HSBNE/VendingMachine_MotorDriver/PCB/Main v1.2/Project Outputs for HSBNE-MAIN/Gerber/HSBNE-MOTOR.TXT

M48
;Layer_Color=9474304
;FILE_FORMAT=4:4
METRIC,LZ
;TYPE=PLATED
T1F00S00C0.3000
T2F00S00C0.8000
T3F00S00C1.0000
T4F00S00C1.0160
T5F00S00C1.1000
T6F00S00C1.5000
T7F00S00C1.6000
T8F00S00C4.5000
;TYPE=NON_PLATED
T9F00S00C0.9000
T10F00S00C2.0000
T11F00S00C3.0000
T12F00S00C3.2500
T13F00S00C4.5000
%
T01
X000381Y-0089027
X000762Y-0088011
X0015113Y-0089662
X001524Y-009398
X0017907Y-0094742
X0018034Y-0096901
X0019177Y-0098171
X0020955Y-0092964
X0018034Y-0092202
X0027559Y-0093472
Y-0096012
X0029464Y-009525
X0031877Y-009652
X0034036Y-0096393
X0034163Y-0092075
X0037084Y-009271
X004064
Y-0095885
X0039116Y-0099441
X0048895Y-0096774
Y-0093472
Y-0090043
X0031496Y-0093091
X0027686Y-0090424
X0056388Y-0091313
X0058801Y-0090043
X0060706Y-0090297
X0061849Y-0088011
X0065786
X0066548Y-0087503
X0058801Y-0093472
Y-0096774
X0093345Y-0092329
X009779Y-0089408
X0101346Y-0087376
X0104521
X0105029Y-0092075
X0105791Y-0091567
X010287Y-0092202
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
