HSBNE/VendingMachine_MotorDriver/PCB/Main v1.2/Project Outputs for HSBNE-MAIN/BOM/Main.xls

Sheet: BOM Report
Footprint | Comment | LibRef | Designator | Description | Quantity | Supplier 1 | Supplier Part Number 1 | Found
RESC2010(5025)_M | 0.1R 1% | CMP-1017-00001-1 | R9, R10 | 0.1R 2010 1% | 2 | Digi-Key | 73L6R10JCT-ND | Y
RESC0603(1608)_M | 1K5 5% | CMP-1012-00078-1 | R7, R8, R27, R28 | 1K5 0.1W 5% 0603 (1608 Metric) SMD | 4 | Digi-Key | P1.5KGCT-ND | Y
RESC0603(1608)_N | 2K 5% | CMP-1012-00081-1 | R20 | 2K 0.1W 5% 0603 (1608 Metric) SMD | 1 | Digi-Key | P2.0KGCT-ND | Y
RESC0603(1608)_M | 2K43 5% | CMP-1012-00083-1 | R19, R32, R33, R35, R36 | 2K43 0.1W 5% 0603 (1608 Metric) SMD | 5 | Digi-Key | P2.43KHCT-ND | Y
CAPC1210(3225)280_M | 2.2uF 50V 1210 | CMP-1038-02102-1 | C2, C3 | CAP 2.2uF 50V ±20% 1210 (3225 Metric) Thickness 2.8mm SMD | 2 | Digikey | 399-8231-6-ND | Y
RESC0603(1608)_M | 4K87 1% | CMP-1012-00090-1 | R25 | 4K87 0.1W 1% 0603 (1608 Metric) SMD | 1 | Digi-Key | P4.87KHCT-ND | Y
RESC0603(1608)_L | 8K2 5% | CMP-1012-00096-1 | R6 | 8K2 0.1W 5% 0603 (1608 Metric) SMD | 1 | Digikey | P8.2KGCT-ND | Y
RESC0603(1608)_M, RESC0603(1608)_N, RESC0603(1608)_N, RESC0603(1608)_N, RESC0603(1608)_N, RESC0603(1608)_N, RESC0603(1608)_N, RESC0603(1608)_N, RESC0603(1608)_M, RESC0603(1608)_M | 10K 5% | CMP-1012-00098-1 | R1, R2, R3, R4, R37, R38, R39, R40, R41, R42 | 10K 0.1W 5% 0603 (1608 Metric) SMD | 10 | Digi-Key | P10KGCT-ND | Y
RESC0603(1608)_M | 10R 5% | CMP-1012-00026-1 | R11, R12, R26, R31 | 10R 0.1W 5% 0603 (1608 Metric) SMD | 4 | Digi-Key | 311-10GRCT-ND | Y
CAPC1210(3225)220_N | 22uF 6.3V 1210 | CMP-1038-02259-1 | C4 | CAP 22uF 6.3V ±10% 1210 (3225 Metric) Thickness 2.2mm SMD | 1 | Digikey | 399-3303-1-ND
Crystal 3.2x2.5 | 25MHz | Crystal_25MHz | Y1 | Surface Mount Quartz Crystal | 1 | Digi-Key | 644-1259-1-ND | Y
RESC0603(1608)_M | 49.9R 1% | CMP-1012-00042-1 | R13, R14, R15, R16 | 49.9R 0.1W 1% 0603 (1608 Metric) SMD | 4 | Digi-Key | 541-49.9HCT-ND | Y
CAPC0603(1608)100_M | 100nF 50V 0603 | CMP-1035-02594-1 | C9, C22 | CAP 100nF 50V -20% to +80% 0603 (1608 Metric) Thickness 1mm SMD | 2 | Digikey | 311-1343-1-ND
PANASONIC_C | 100uF | Cap_Polarized_100uF | C13 | Polarized Capacitor (Surface Mount) | 1 | Digi-Key | PCE4718CT-ND | x
RESC0603(1608)_M | 220R 5% | CMP-1012-00058-1 | R5, R17, R18, R21, R30, R34 | 220R 0.1W 5% 0603 (1608 Metric) SMD | 6 | Digi-Key | P220GCT-ND | Y
PANASONIC_H13 | 1000uF | Cap_Polarized_1000uF | C23 | Polarized Capacitor (Surface Mount) | 1 | Digi-Key | PCE3462CT-ND | Y
MOLX-67503-1020_V | 67503-1020 | CMP-0411-00002-1 | J7 | USB, MINI, SMD, RA KME04-USBMU03A01 | 1 | Digi-Key | WM5461CT-ND
SOT-223 | AZ1117EH-3.3TRG1 | AZ1117EH | U32 | Reg 1A 3V3 OUT SIP VERT | 1 | Digi-Key | AZ1117EH-3.3TRG1DICT-ND | Y
CAPC0603(1608)100_M | CAP 1uF 25V | CMP-1035-00037-1 | C1, C10, C11, C18, C19, C30, C31 | CAP 1uF 25V Â±0.25pF 0603 (1608 Metric) Thickness 1mm SMD | 7 | Digi-Key | 1276-1102-1-ND | Y
CAPC0603(1608)100_M | CAP 4.7nF 50V | CMP-1035-00333-1 | C6 | CAP 4.7nF 50V Â±20% 0603 (1608 Metric) Thickness 1mm SMD | 1 | Digi-Key | 478-1223-1-ND
CAPC0603(1608)100_M | CAP 10uF 6.3V | CMP-1035-02796-1 | C29 | CAP 10uF 6.3V ±10% 0603 (1608 Metric) Thickness 1mm SMD | 1 | Digikey | 311-1781-1-ND | Y
CAPC1206(3216)190_M | CAP 10uF 50V | CMP-1037-04982-1 | C8 | CAP 10uF 50V Â±10% 1206 (3216 Metric) Thickness 1.9mm SMD | 1 | Digikey | 445-5998-1-ND | Y
CAPC0603(1608)100_L | CAP 12pF 16V | CMP-1035-00602-1 | C25, C26 | CAP 12pF 16V Â±0.25pF 0603 (1608 Metric) Thickness 1mm SMD | 2 | Digi-Key | 478-1164-1-ND | Y
CAPC0805(2012)100_M | CAP 22nF 25V | CMP-1036-04051-1 | C5 | CAP 22nF 25V Â±5% 0805 (2012 Metric) Thickness 1mm SMD | 1 | Digi-Key | 1276-2491-1-ND | Y
CAPC1206(3216)100_L | CAP 47uF 25V | CMP-1037-00376-1 | C7 | CAP 47uF 25V Â±0.25pF 1206 (3216 Metric) Thickness 1mm SMD | 1 | Digikey | 445-11717-1-ND | Y
CAPC0603(1608)100_M | CAP 100nF 50V | CMP-1035-00010-1 | C12, C14, C15, C16, C17, C20, C21, C28 | CAP 100nF 50V Â±0.1pF 0603 (1608 Metric) Thickness 1mm SMD | 8 | Digi-Key | 311-1343-1-ND | Y
DIP8 | DIP Switch 8 | DIP8 | J11 |  | 1 | Digikey | CT3111-ND | Y
0603 | DNP | Cap_100pF | C24 | 100nF | 1 | Digi-Key | 399-1096-1-ND | -
1X6 | FTDI Header | Header 6 | JP7 | Header, 6-Pin | 1 | Digi-Key | 952-2270-ND | Y
FUSE_HOLDER | FUSE-2 | FUSE-2 | F1 |  | 1 | Digi-Key | F064-ND | Y
SOT-23 - ESD | GSOT12C | 2749 | D3, D4 | DIO GSOT12C ESD 2LINE 12V SOT23 | 2 | Digikey | GSOT12C-E3-08CT-ND
Molex 39-30-1040 | Header 2x2 2.54mm | Header 2x2 | J6, J12 | Header, 4-Pin | 2 | Farnell | WM1352-ND | -
2X3 | Header 3x2 2.54mm | Header 3x2 | JP4, JP8 | Header, 6-Pin | 2 | Digi-Key | 952-1788-ND | -
2X5 | Header 5x2 2.54mm | Header 5x2 | JP1, JP2, JP3 | Header, 8-Pin | 3 | Farnell | 609-3243-ND | -
SP10 | ina226 | ina226 | U38, U39 | ina226 | 2 | Digi-Key | 296-29034-1-ND | Y
INF-SOT223_M | ITS4200S-ME-O | CMP-1095-00143-1 | U36, U37 | Smart High-Side NMOS-Power Switch, 11 to 45 V Operating, -40 to 125 degC, SOT223, Reel, Green | 2 | Digi-Key | ITS4200SMEOHUMA1CT-ND | Y
LED-0603 | LED | LED | D1, D2, D5, D6, D7, D9 | Typical RED, GREEN, YELLOW, AMBER GaAs LED | 6 | Digikey | SML-D12M1WT86TR-ND
NDY0011A_M | LMZ23610TZ/NOPB | CMP-0069-02067-2 | U33 | 10A SIMPLE SWITCHER® Power Module with 36V Maximum Input Voltage and Current Sharing, 11 pin TO-PMOD, 32 Rail | 1 | Digikey | LMZ23610TZ/NOPB-ND | Y
magjack | MAGJACK | MagJack | J10 |  | 1 | Digikey | ARJC02-111006E-ND
0603 | MPZ1608S102A | 2982 | L1, L2, L3 | IND FERRITE CHIP BEAD 1000 OHM @ 100MHz 800mA 0603 | 3 | Digikey | 445-8694-6-ND | Y
ONSC-UDFN-8-517AD_V | NUF4001MUT2G | CMP-1066-00052-1 | U43, U44, U45 | 4-Channel EMI Filter with Integrated ESD Protection, -40 to 85 degC, 8-Pin UDFN, Pb-Free, Tape and Reel | 3 | Digikey | NUF4001MUT2GOSCT-ND | Y
Buck_mod | R-78E3.3-0.5 | Buck 3V3 OUT SIP VERT | U42 | 3V3 OUT SIP VERT | 1 | Digikey | 945-1661-5-ND | x
PCA82C250, excludes pin5 | SN65HVD234D | CMP-0315-00083-1 | U35 | 3.3V CAN Transceiver with Sleep Mode, 6 mA, -40 to 125 degC, 8-pin SOIC (D), Green (RoHS & no Sb/Br) | 1 | Digi-Key | 296-27991-1-ND
SPADE-6.35-RA | SPADE | CON2 | J3, J4 | 6.35mm right-angle 90° male spade terminal PCB mount | 2 |  |  | -
TI-PDT128_M | TM4C1294NCPDTI3R | CMP-0945-00007-1 | U1 | Tiva C Series Microcontroller, 1024 KB Flash, 256 KB SRAM, 12 Bit, 20 Channels, -40 to 85 degC, 128-Pin TQFP (PDT), Green (RoHS & no Sb/Br), Tape and Reel | 1 | Digi-Key | 296-37942-ND | Y
M5569-2 | WM1351-ND | CON2 | J5 | 6.35mm right-angle 90° male spade terminal PCB mount | 1 | Digikey | WM1351-ND | -
M43045H-6 | WM1815-ND | CON6 | J1, J2 |  | 2 | Digikey | WM1815-ND | Y
SO-8 | ZXMS6004N8 | ZXMS6004N8 | U2, U3, U4, U5, U6, U7, U8, U9, U10, U11, U12, U13, U14, U15, U16, U17, U18, U19, U20, U21, U22, U23, U24, U25, U26, U27, U28, U29, U30, U31, U34, U40, U41 | MOSFET N-CH 60V 1.3A S08 | 33 | Digikey | ZXMS6004N8-13DICT-ND | Y
 |  |  |  |  | 142

Sheet: Project Information
Project Full Path | Z:\Altuim\VendingMachine\Main v1.2\HSBNE-MAIN.PrjPcb
Project Filename | HSBNE-MAIN.PrjPcb
Variant Name | None
Data-Source Filename | Hsbne-Vend.BomDoc
Data-Source Full Path | Z:\Altuim\VendingMachine\Main v1.2\Hsbne-Vend.BomDoc
Title | <Parameter Title not found>
Total Quantity | 144
Report Time | 7:57:11 PM
Report Date | 4/9/2017
Report Date & Tine | 4/9/2017 7:57:11 PM
Output Name | Bill of Materials
Output Type | BOM_PartType
Output Generator Name | BOM
Output Generator Description | Bill of Materials
