HSBNE/VendingMachine_MotorDriver/3dPrintGears/Vending_gear_20T.SLDPRT

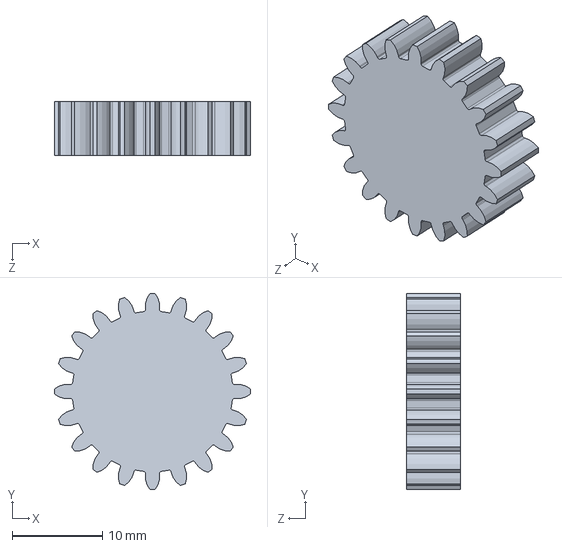
[picture p2: CAD file, 2018-12-03]
3dPrintGears/Vending_gear_20T.SLDPRT
21.7 x 21.7 x 6.00 mm
