HSBNE/VendingMachine_MotorDriver/3dPrintGears/Vending_gear_10T.SLDPRT

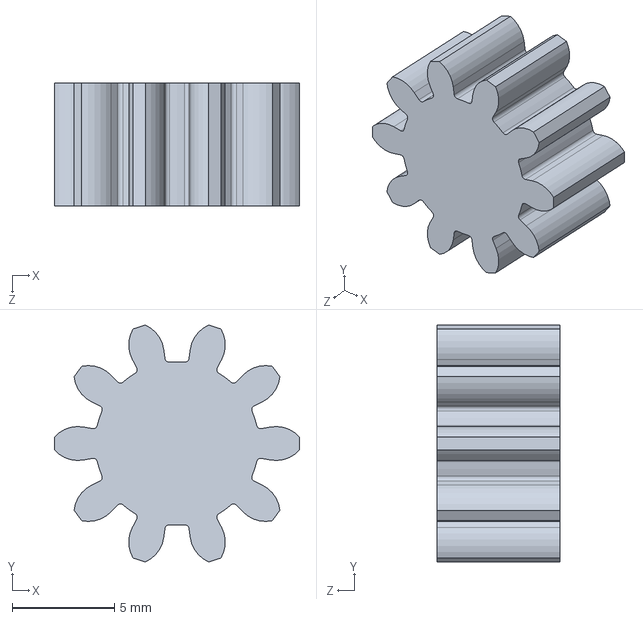
[picture p3: CAD file, 2018-12-03]
3dPrintGears/Vending_gear_10T.SLDPRT
12.0 x 11.6 x 6.00 mm
