HSBNE/VendingMachine_MotorDriver/PCB/Main v1.2/Project Outputs for HSBNE-MAIN/HSBNE-MAIN.PDF

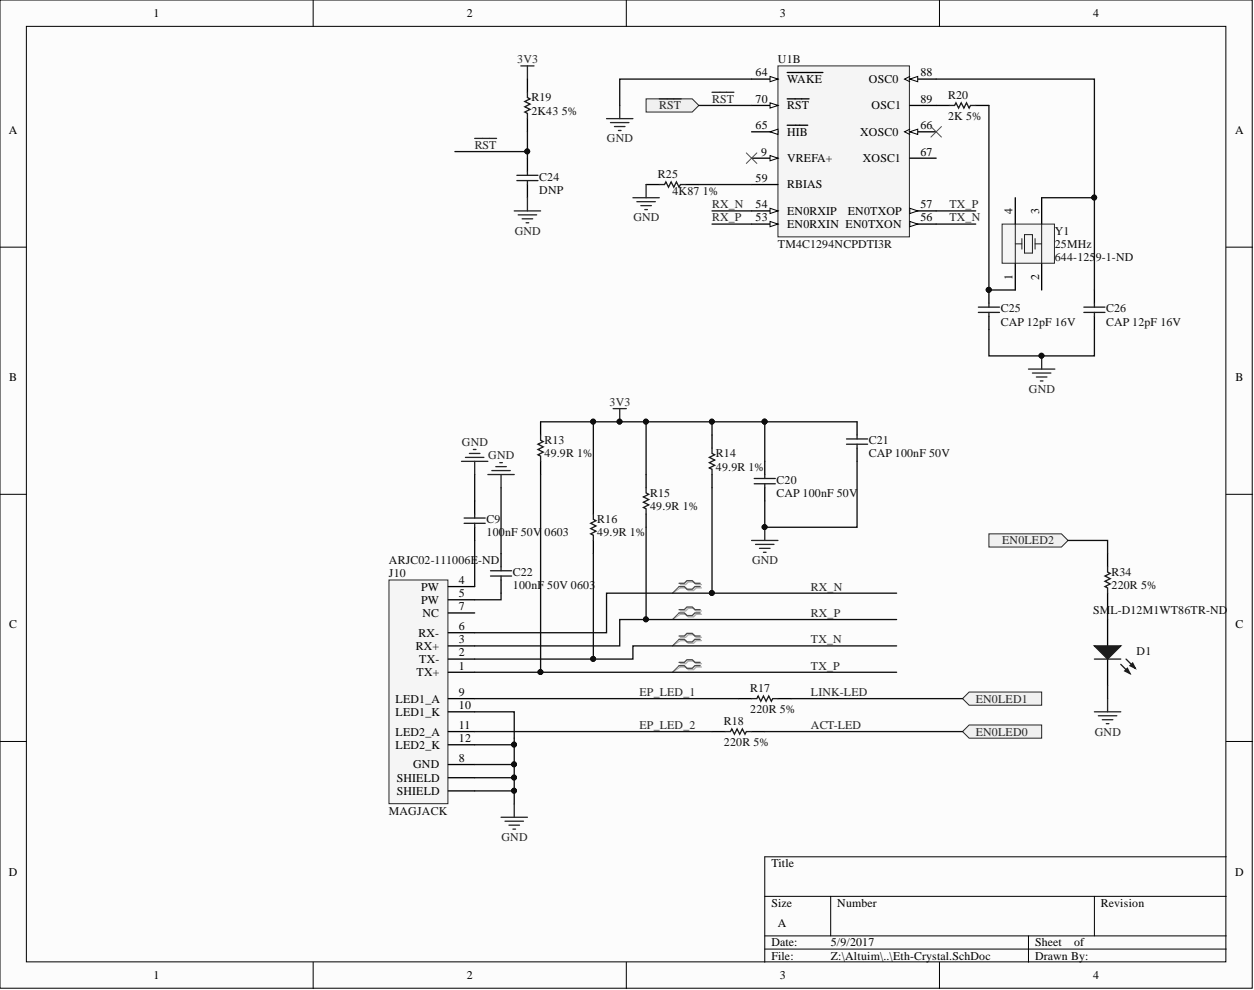
[picture p4: page 1]

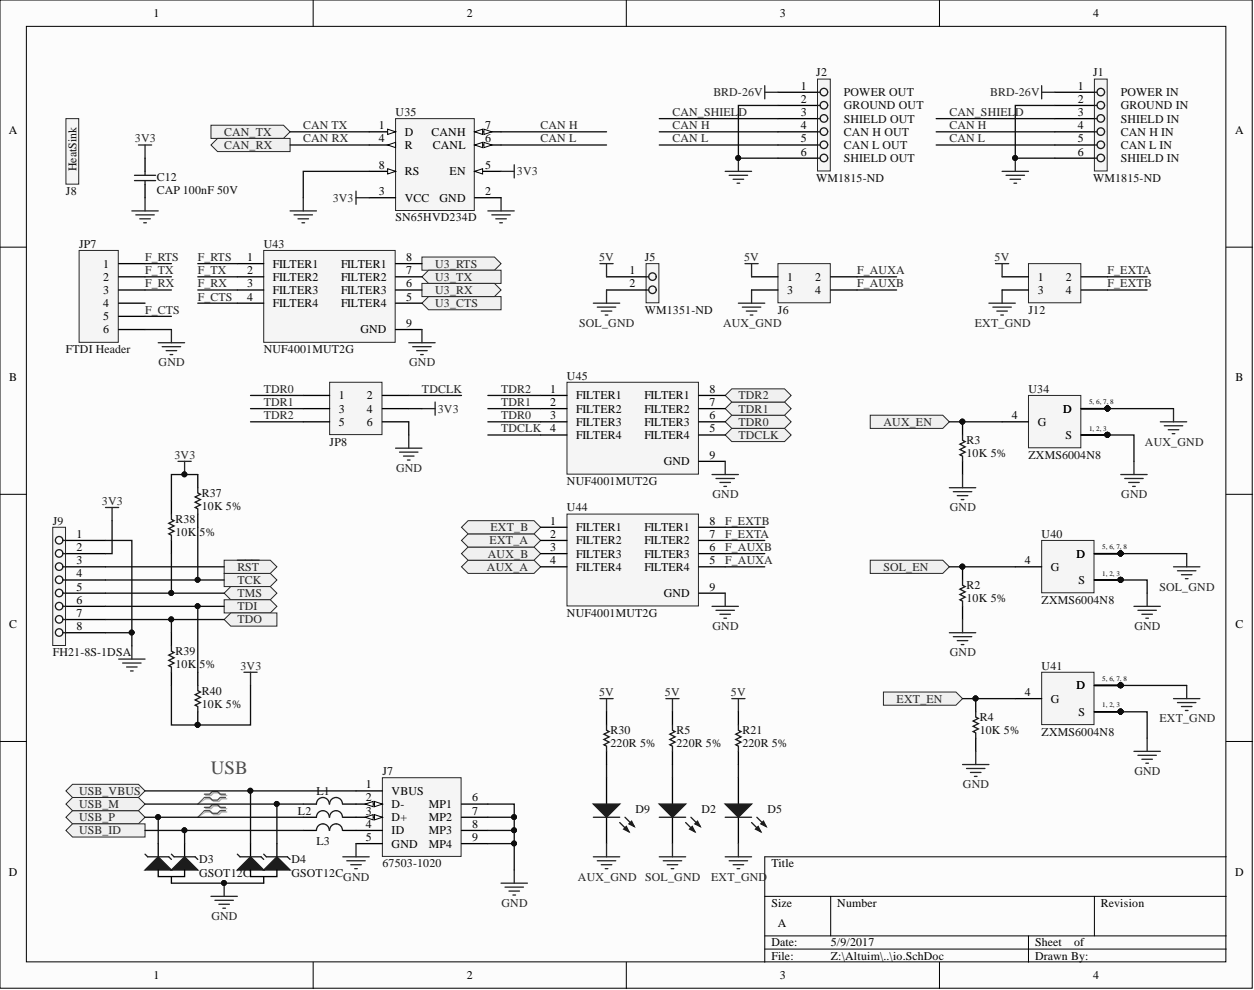
[picture p5: page 2]

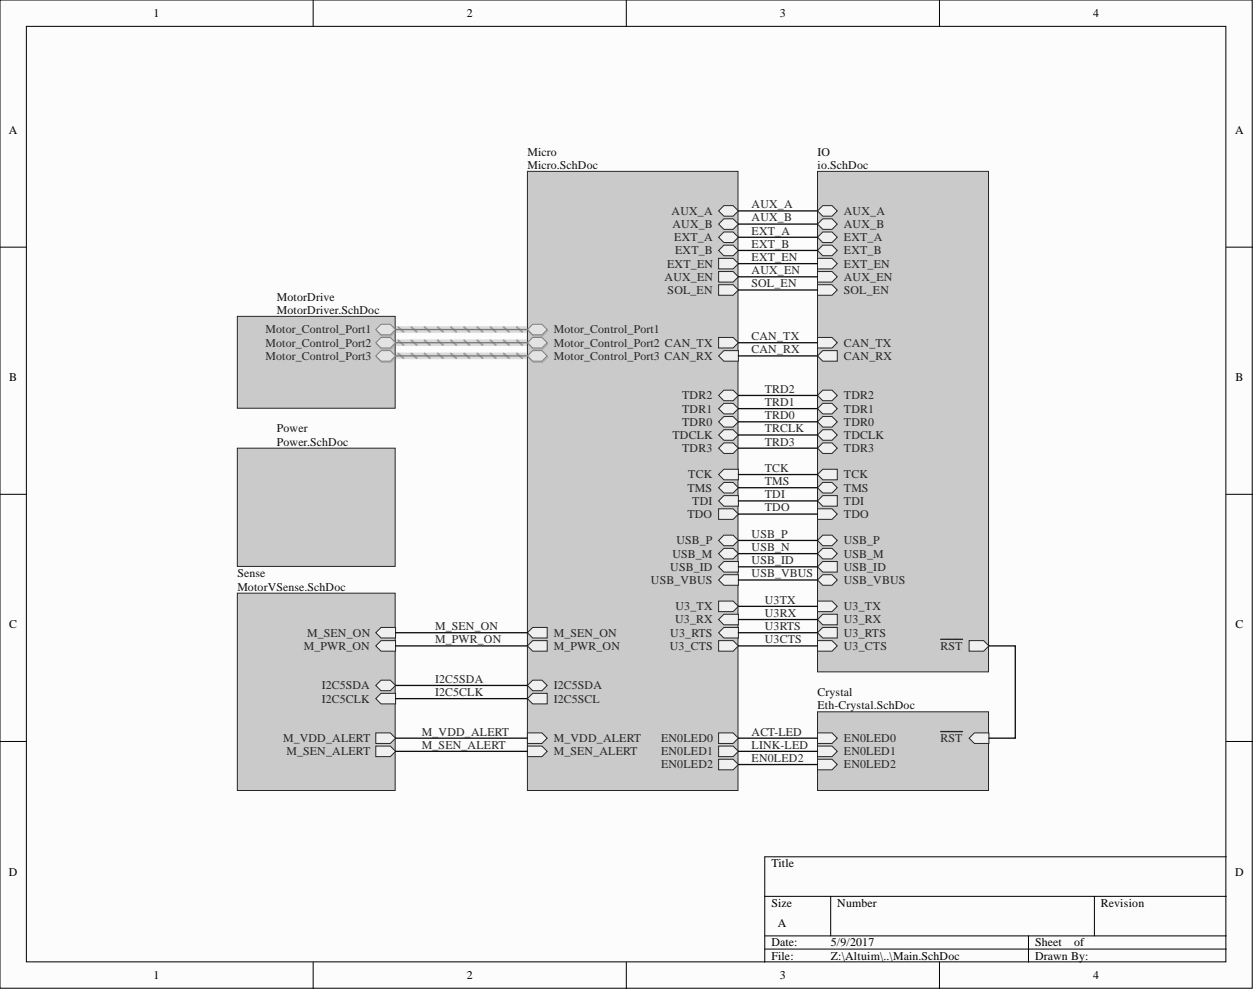
[picture p6: page 3]

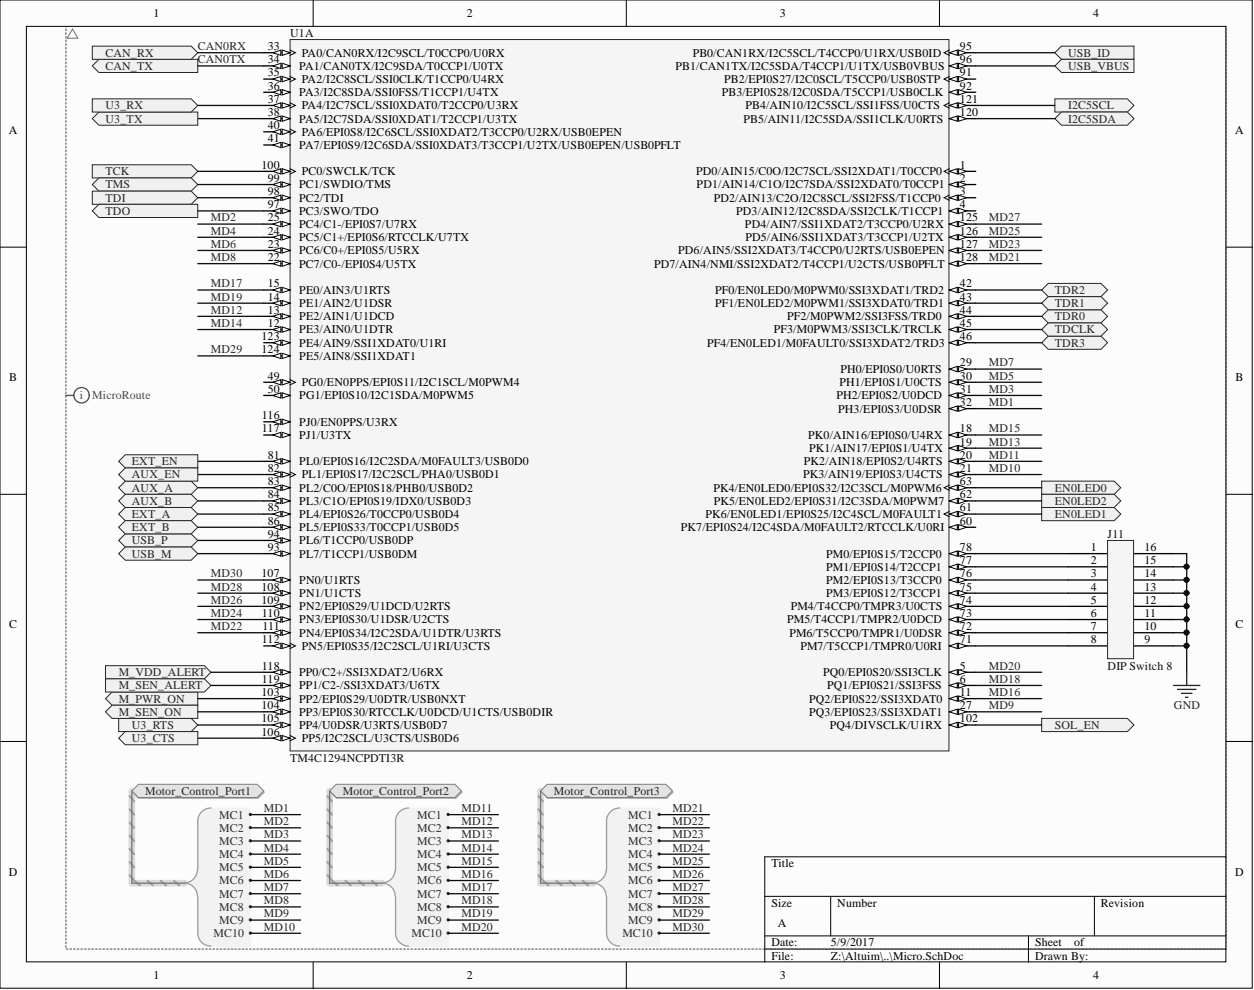
[picture p7: page 4]

PN0/U1RTS 107 | 2 | 15

PN1/U1CTS 108 | 4 | 13
PN2/EPI0S29/U1DCD/U2RTS 109 | 5 | 12
PN3/EPI0S30/U1DSR/U2CTS 110 | 6 | 11
PN4/EPI0S34/I2C2SDA/U1DTR/U3RTS 111 | 7 | 10
PN5/EPI0S35/I2C2SCL/U1RI/U3CTS 112 PP0/C2+/SSI3XDAT2/U6RX 118 PP1/C2-/SSI3XDAT3/U6TX 119 PP2/EPI0S29/U0DTR/USB0NXT 103 | 8 | 9

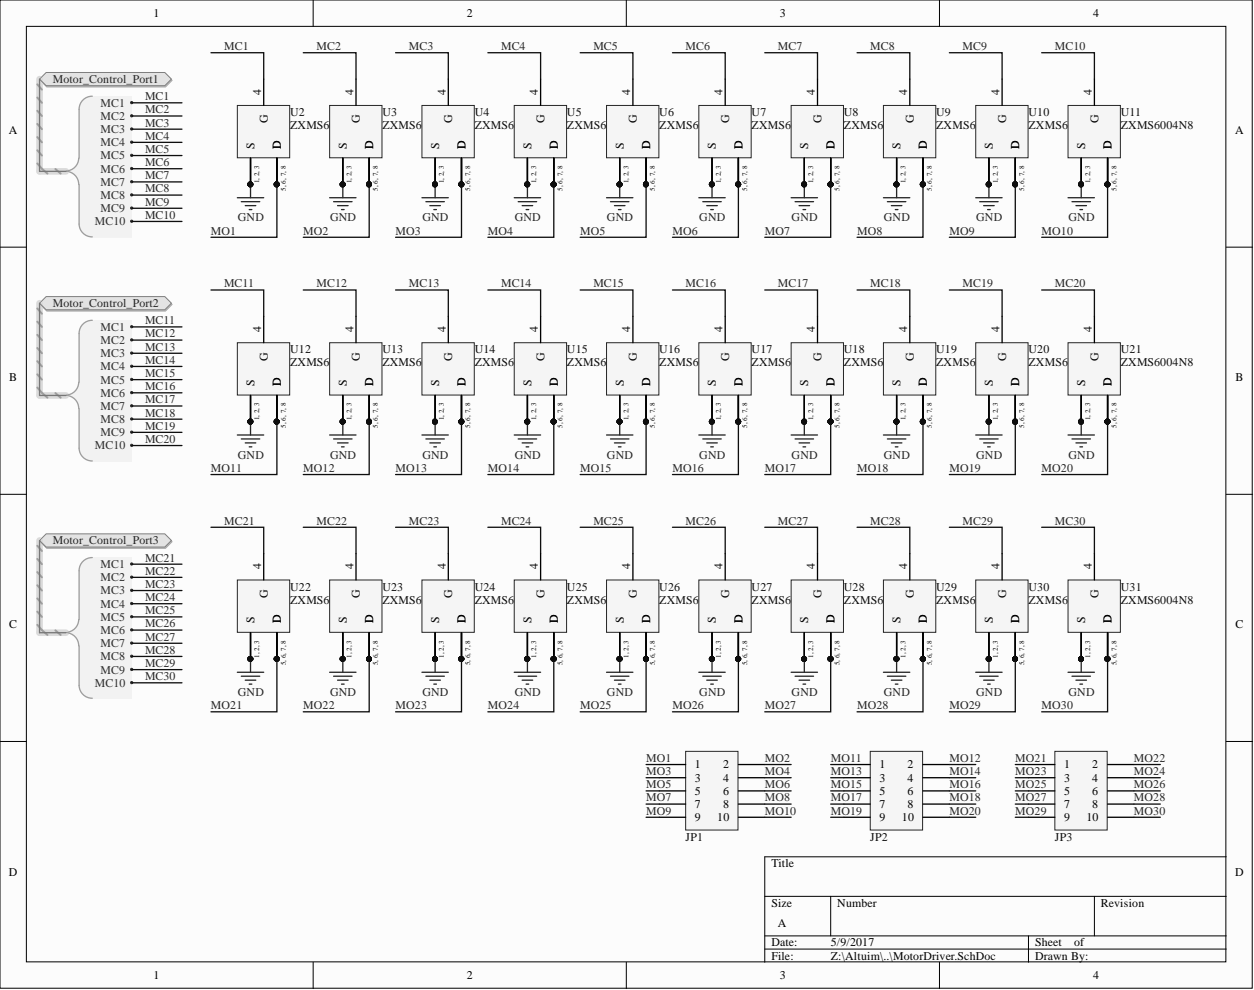
[picture p8: page 5]

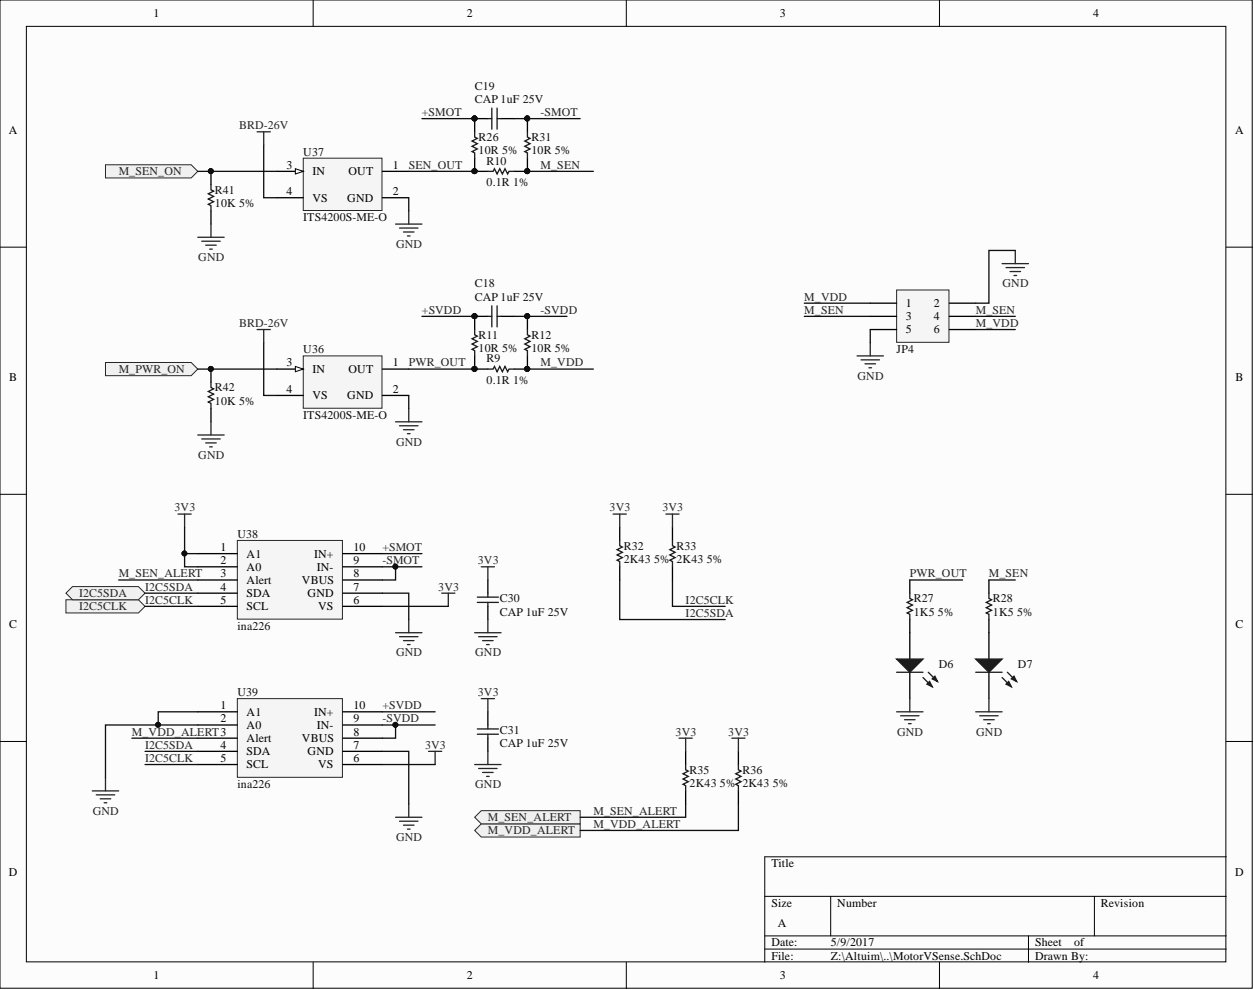
[picture p9: page 6]

A0 2 | -SVDD

M_VDD_ALERT I2C5SDA I2C5CLK | Alert 3 SDA 4

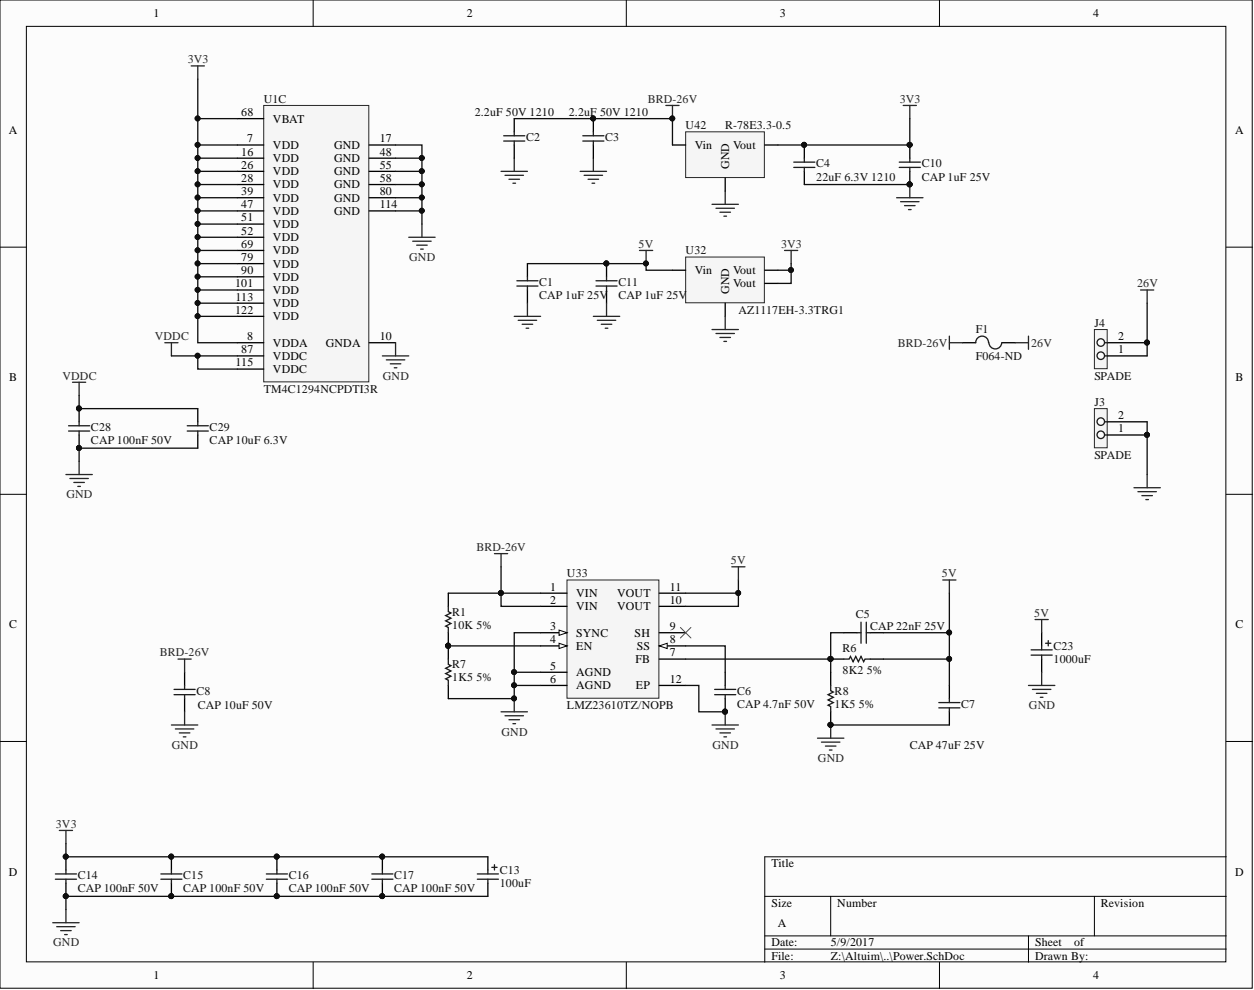
[picture p10: page 7]
