HSBNE/VendingMachine_MotorDriver/(list of files, drawings)

Other design files:
PCB/Input 1v1/buttonInput.SchDoc
PCB/Input 1v1/Eth-Crystal.SchDoc
PCB/Input 1v1/HSBNE-INPUT.PrjPcb
PCB/Input 1v1/HSBNE-Vend.PcbLib
PCB/Input 1v1/HSBNE-Vend.SchLib
PCB/Input 1v1/io.SchDoc
PCB/Input 1v1/Main.SchDoc
PCB/Input 1v1/Micro.SchDoc
PCB/Input 1v1/Power.SchDoc
PCB/Input/buttonInput.SchDoc
PCB/Input/Eth-Crystal.SchDoc
PCB/Input/HSBNE-INPUT.PrjPcb
PCB/Input/HSBNE-IO.PcbDoc
PCB/Input/HSBNE-Vend.PcbLib
PCB/Input/HSBNE-Vend.SchLib
PCB/Input/io.SchDoc
PCB/Input/Main.SchDoc
PCB/Input/Micro.SchDoc
PCB/Input/Power.SchDoc
PCB/Main v1.2/Eth-Crystal.SchDoc
PCB/Main v1.2/HSBNE-MAIN.PrjPcb
PCB/Main v1.2/HSBNE-MAIN.SCHLIB
PCB/Main v1.2/HSBNE-MOTOR.PcbLib
PCB/Main v1.2/HSBNE-Vend.PcbLib
PCB/Main v1.2/HSBNE-Vend.SchLib
PCB/Main v1.2/io.SchDoc
PCB/Main v1.2/Main.SchDoc
PCB/Main v1.2/Micro.SchDoc
PCB/Main v1.2/MotorDriver.SchDoc
PCB/Main v1.2/MotorVSense.SchDoc
PCB/Main v1.2/Power.SchDoc
