HSBNE/VendingMachine_MotorDriver/(commit log)

2015-11-21 Main motor controller PCB complete
    [Eth-Crystal.SchDoc, HSBNE-MAIN.PrjPcb, HSBNE-MAIN.SCHLIB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]
2015-11-21 Fixed shield connection
    [HSBNE-MOTOR.GBL, HSBNE-MOTOR.GBP, HSBNE-MOTOR.GBS, HSBNE-MOTOR.GKO, HSBNE-MOTOR.GTL, HSBNE-MOTOR.GTO, HSBNE-MOTOR.GTP, HSBNE-MOTOR.GTS]
2015-11-26 Changed 3v3 regulator
    [HSBNE-MAIN.PrjPcb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]
2015-11-26 Added teardrops to new tracks
    [HSBNE-MOTOR.GTL]
2015-11-26 Initial commit of input board to complement Main controller board
    [Eth-Crystal.SchDoc, HSBNE-INPUT.PrjPcb, HSBNE-IO.PcbDoc, HSBNE-Vend.PcbLib, HSBNE-Vend.SchLib, Main.SchDoc, Micro.SchDoc, Power.SchDoc]
2018-12-03 Adding new board design
    [Eth-Crystal.SchDoc, HSBNE-MAIN.PrjPcb, HSBNE-MAIN.SCHLIB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]
2018-12-03 Adding gears to be molded, these have worked well to replace those that have been broken
    [Vending_gear_10T.SLDPRT, Vending_gear_10T_with_keyway.SLDPRT, Vending_gear_20T.SLDPRT]
2019-01-14 Moving some files around
    [Eth-Crystal.SchDoc, HSBNE-INPUT.PrjPcb, HSBNE-IO.PcbDoc, HSBNE-MAIN.PrjPcb, HSBNE-MAIN.SCHLIB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]
2019-02-01 1v1 input pcb
    [Eth-Crystal.SchDoc, HSBNE-INPUT.PrjPcb, HSBNE-Vend.PcbLib, HSBNE-Vend.SchLib, Main.SchDoc, Micro.SchDoc, Power.SchDoc, buttonInput.SchDoc]
2019-02-01 Adding output pin mapping
